loddi-o/bc250-pico-power-bridge/docs/images/board.png

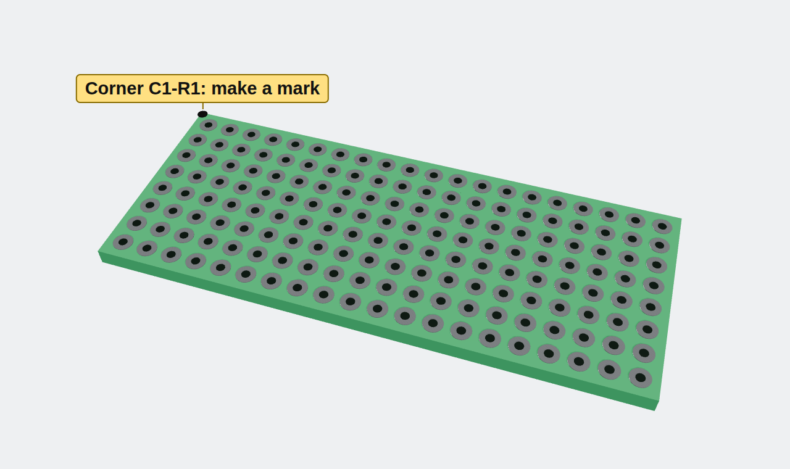
docs/images/board.png
