loddi-o/bc250-pico-power-bridge/docs/images/bridges_bot.png

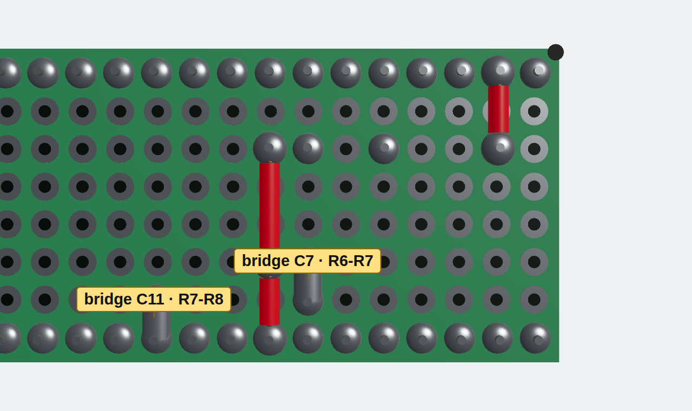
docs/images/bridges_bot.png
