loddi-o/bc250-pico-power-bridge/docs/images/col2_bot.png

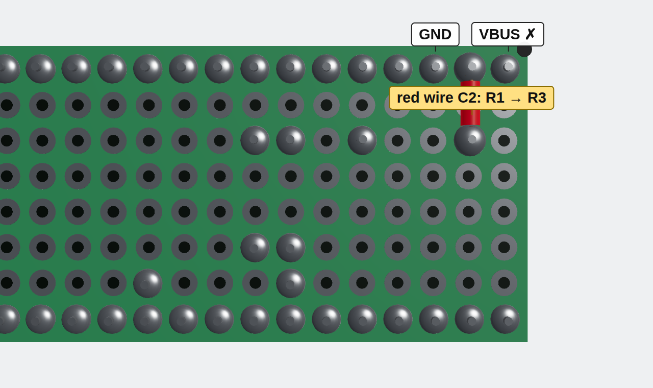
docs/images/col2_bot.png
