loddi-o/bc250-pico-power-bridge/docs/images/col8_bot.png

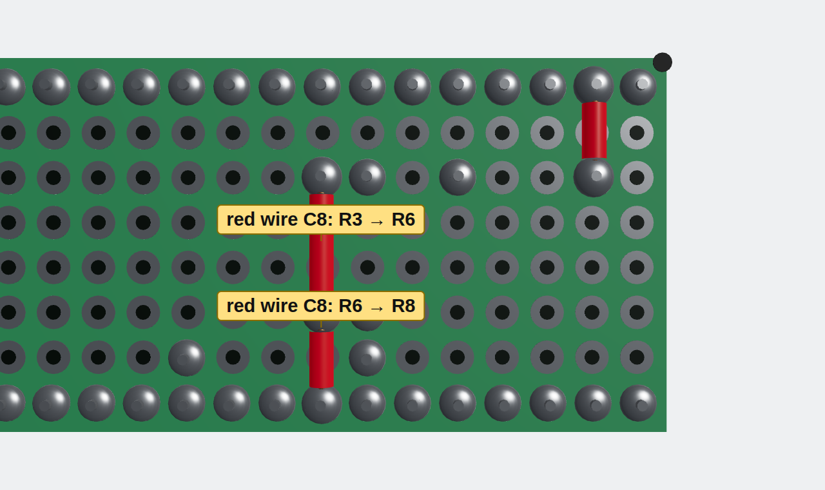
docs/images/col8_bot.png
