loddi-o/bc250-pico-power-bridge/docs/images/cover.png

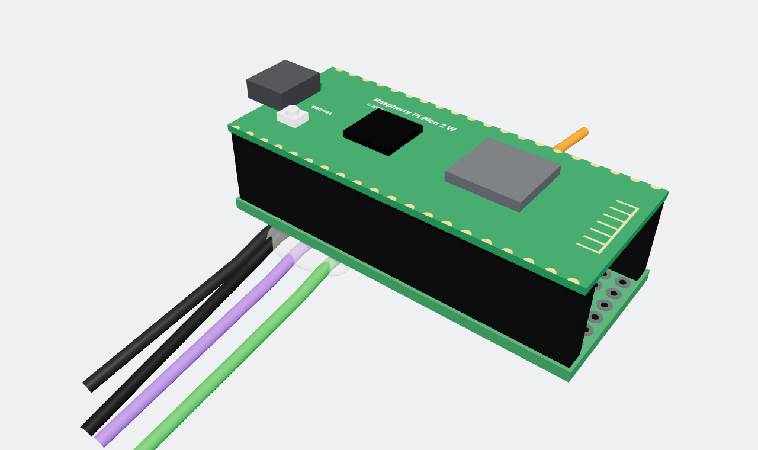
docs/images/cover.png
