loddi-o/bc250-pico-power-bridge/docs/images/diode_bot.png

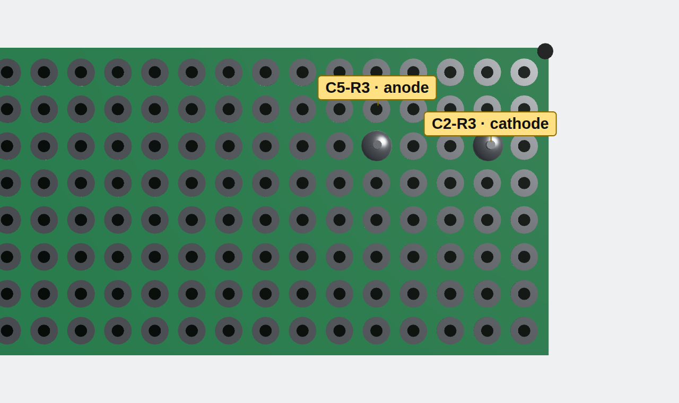
docs/images/diode_bot.png
