loddi-o/bc250-pico-power-bridge/docs/images/diode_top.png

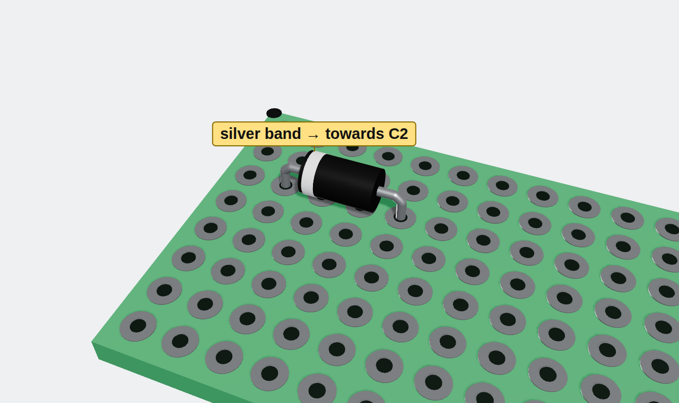
docs/images/diode_top.png
