loddi-o/bc250-pico-power-bridge/docs/images/ext_3d.png

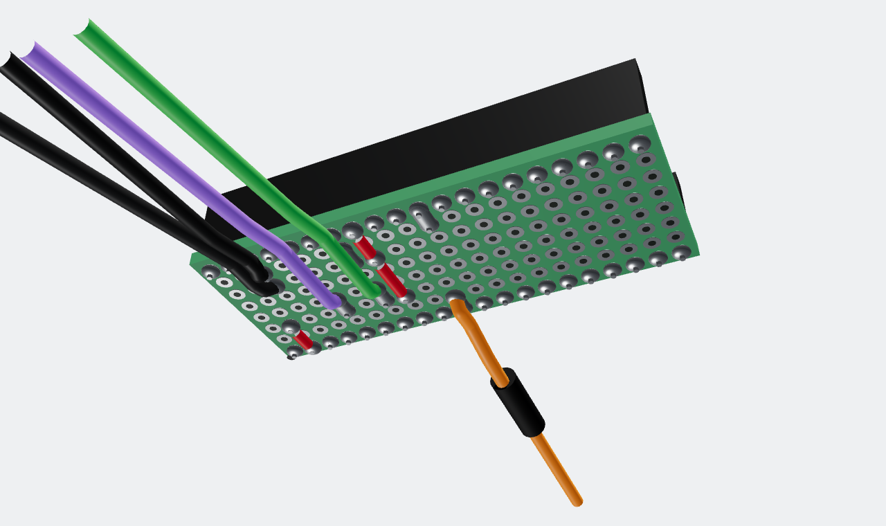
docs/images/ext_3d.png
