loddi-o/bc250-pico-power-bridge/docs/images/pc817_top.png

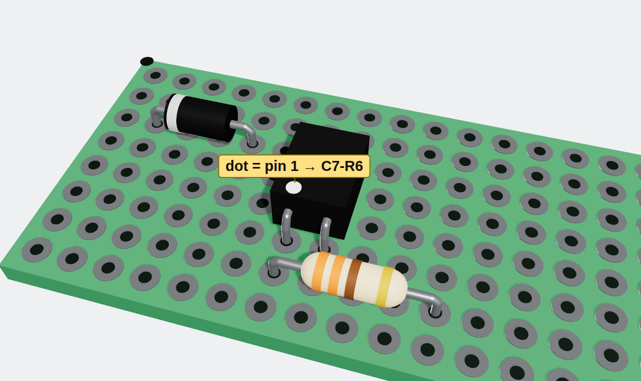
docs/images/pc817_top.png
