loddi-o/bc250-pico-power-bridge/docs/images/r330_top.png

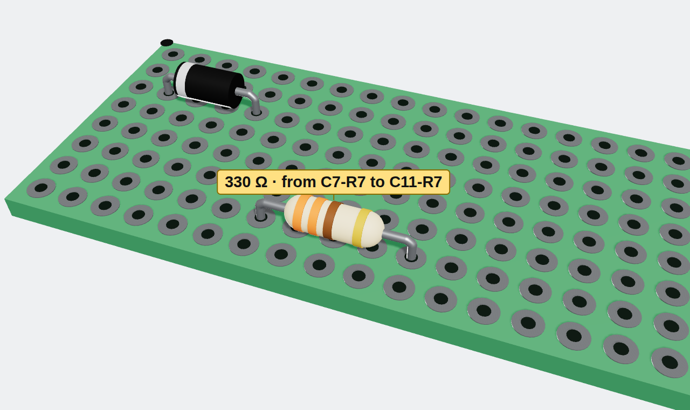
docs/images/r330_top.png
