loddi-o/bc250-pico-power-bridge/docs/images/sockets_bot.png

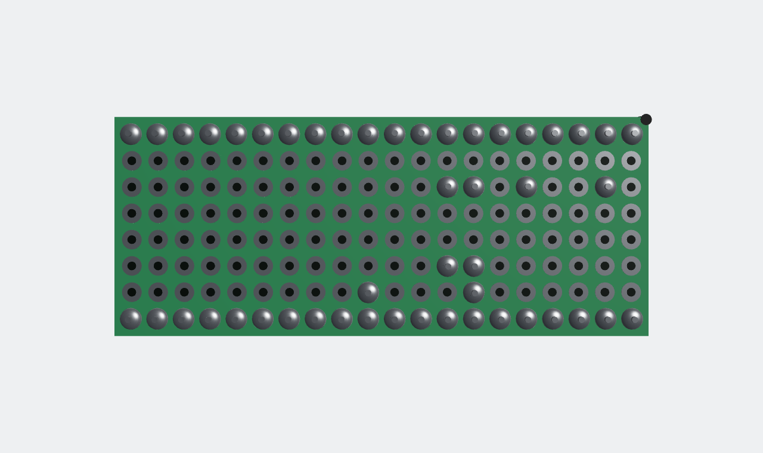
docs/images/sockets_bot.png
