loddi-o/bc250-pico-power-bridge/docs/images/sockets_top.png

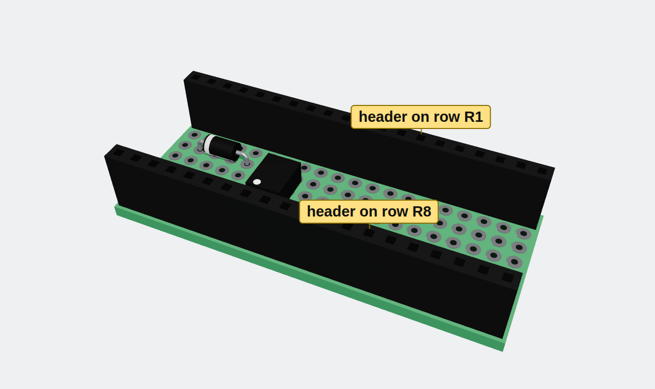
docs/images/sockets_top.png
