loddi-o/bc250-pico-power-bridge/hardware/enclosure/test_piece.stl

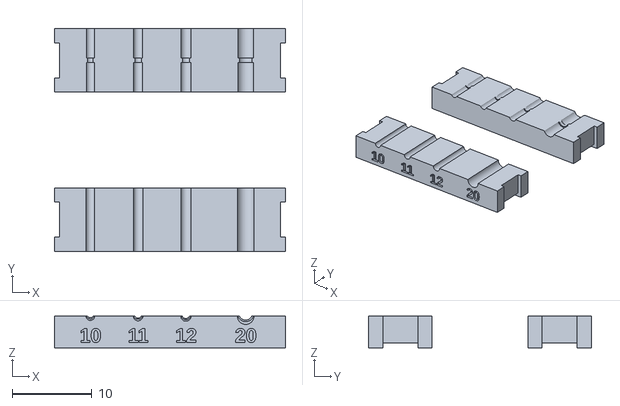
[picture p23: CAD file, 2026-10-09]
hardware/enclosure/test_piece.stl
29.0 x 28.0 x 4.00
