loddi-o/bc250-pico-power-bridge/hardware/redux-button-adapter/button_adapter_12mm_gap0.30.stl

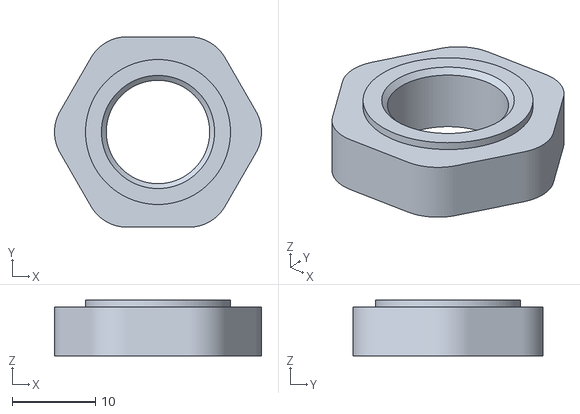
[picture p24: CAD file, 2026-10-09]
hardware/redux-button-adapter/button_adapter_12mm_gap0.30.stl
24.8 x 22.9 x 6.70
