loddi-o/bc250-pico-power-bridge/hardware/ssd-spacer/ssd_spacer.stl

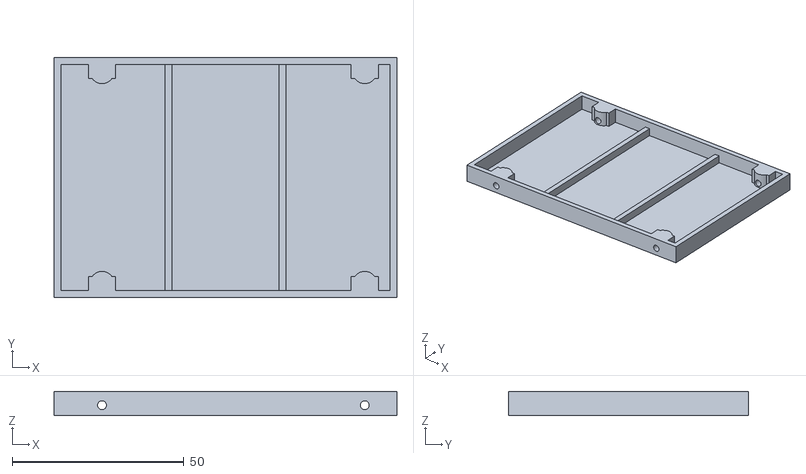
[picture p25: CAD file, 2026-10-09]
hardware/ssd-spacer/ssd_spacer.stl
100.0 x 69.8 x 7.00
