loddi-o/bc250-pico-power-bridge/hardware/enclosure/lid.stl

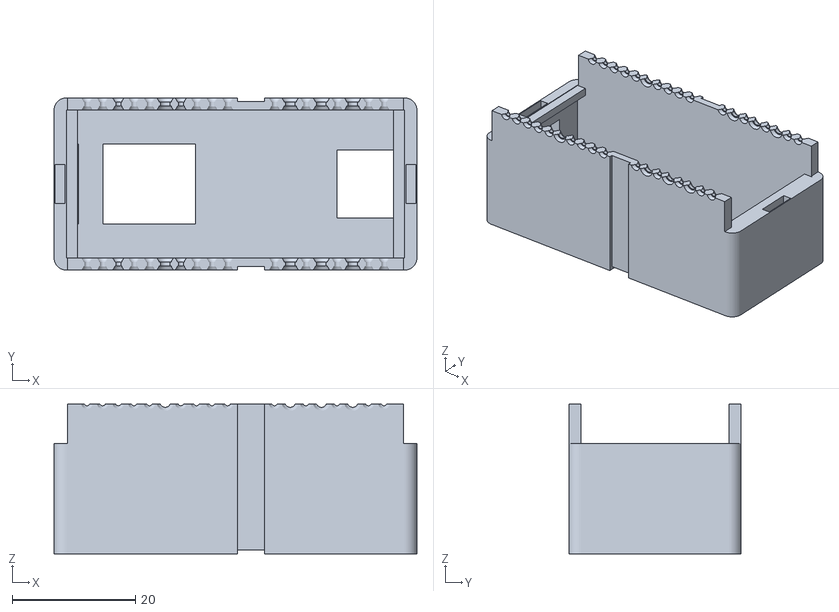
[picture p26: CAD file, 2026-10-09]
hardware/enclosure/lid.stl
59.0 x 28.0 x 24.3
