loddi-o/bc250-pico-power-bridge/hardware/enclosure/base.stl

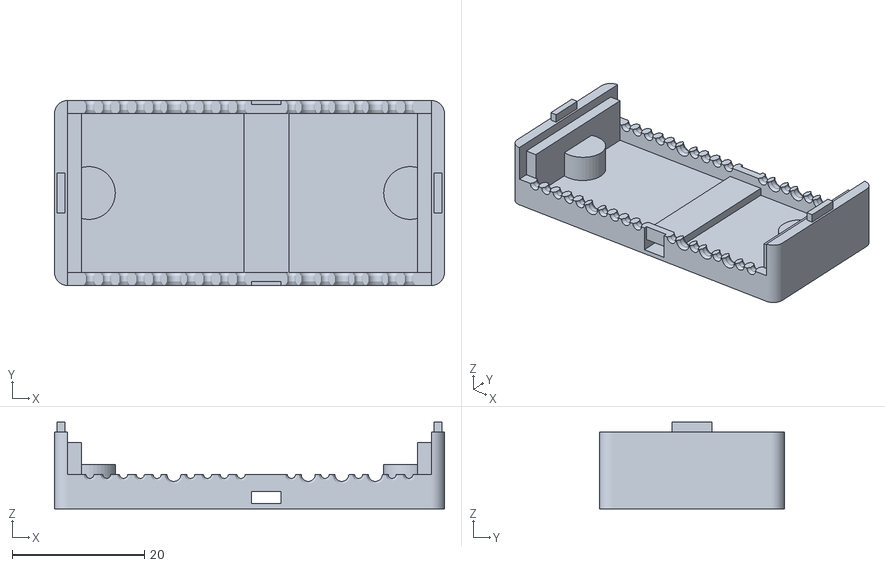
[picture p27: CAD file, 2026-10-09]
hardware/enclosure/base.stl
59.0 x 28.0 x 13.1
