loddi-o/bc250-pico-power-bridge/(list of files, cad)

Other CAD files:
hardware/redux-button-adapter/button_adapter_12mm_gap0.20.stl
